NifleySnifley/RocketTracker/README.md

Currently WIP starting over all software-related development to get back on track making the most efficient design possible.
