NifleySnifley/RocketTracker/hardware/CONREVSMA003.062/CONREVSMA003.062.step

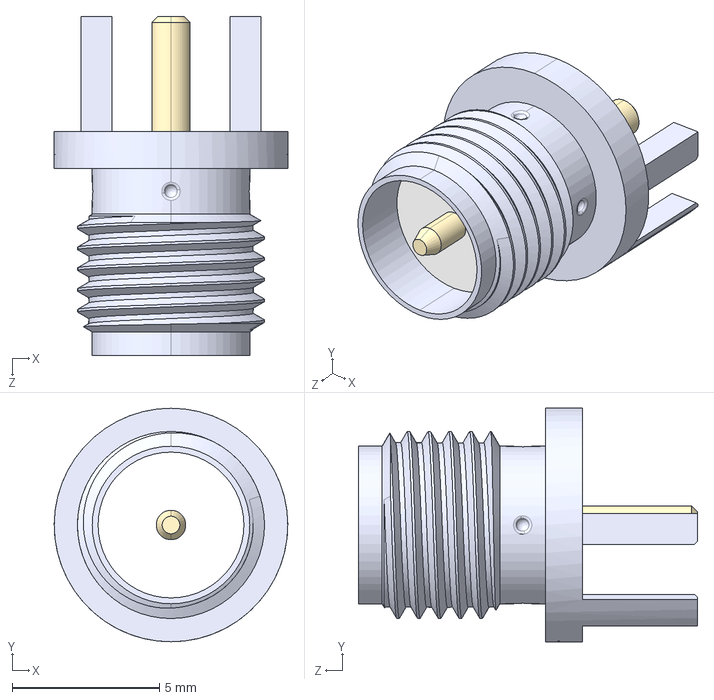
[picture p1: CAD file, 2023-04-13, last stored version]
hardware/CONREVSMA003.062/CONREVSMA003.062.step
7.93 x 7.93 x 11.5 mm
