NifleySnifley/RocketTracker/hardware/Rocket Tracker/Rocket Tracker.kicad_pcb

## KiCad design hardware/Rocket Tracker/Rocket Tracker.kicad_pcb (2023-04-13, last stored version)

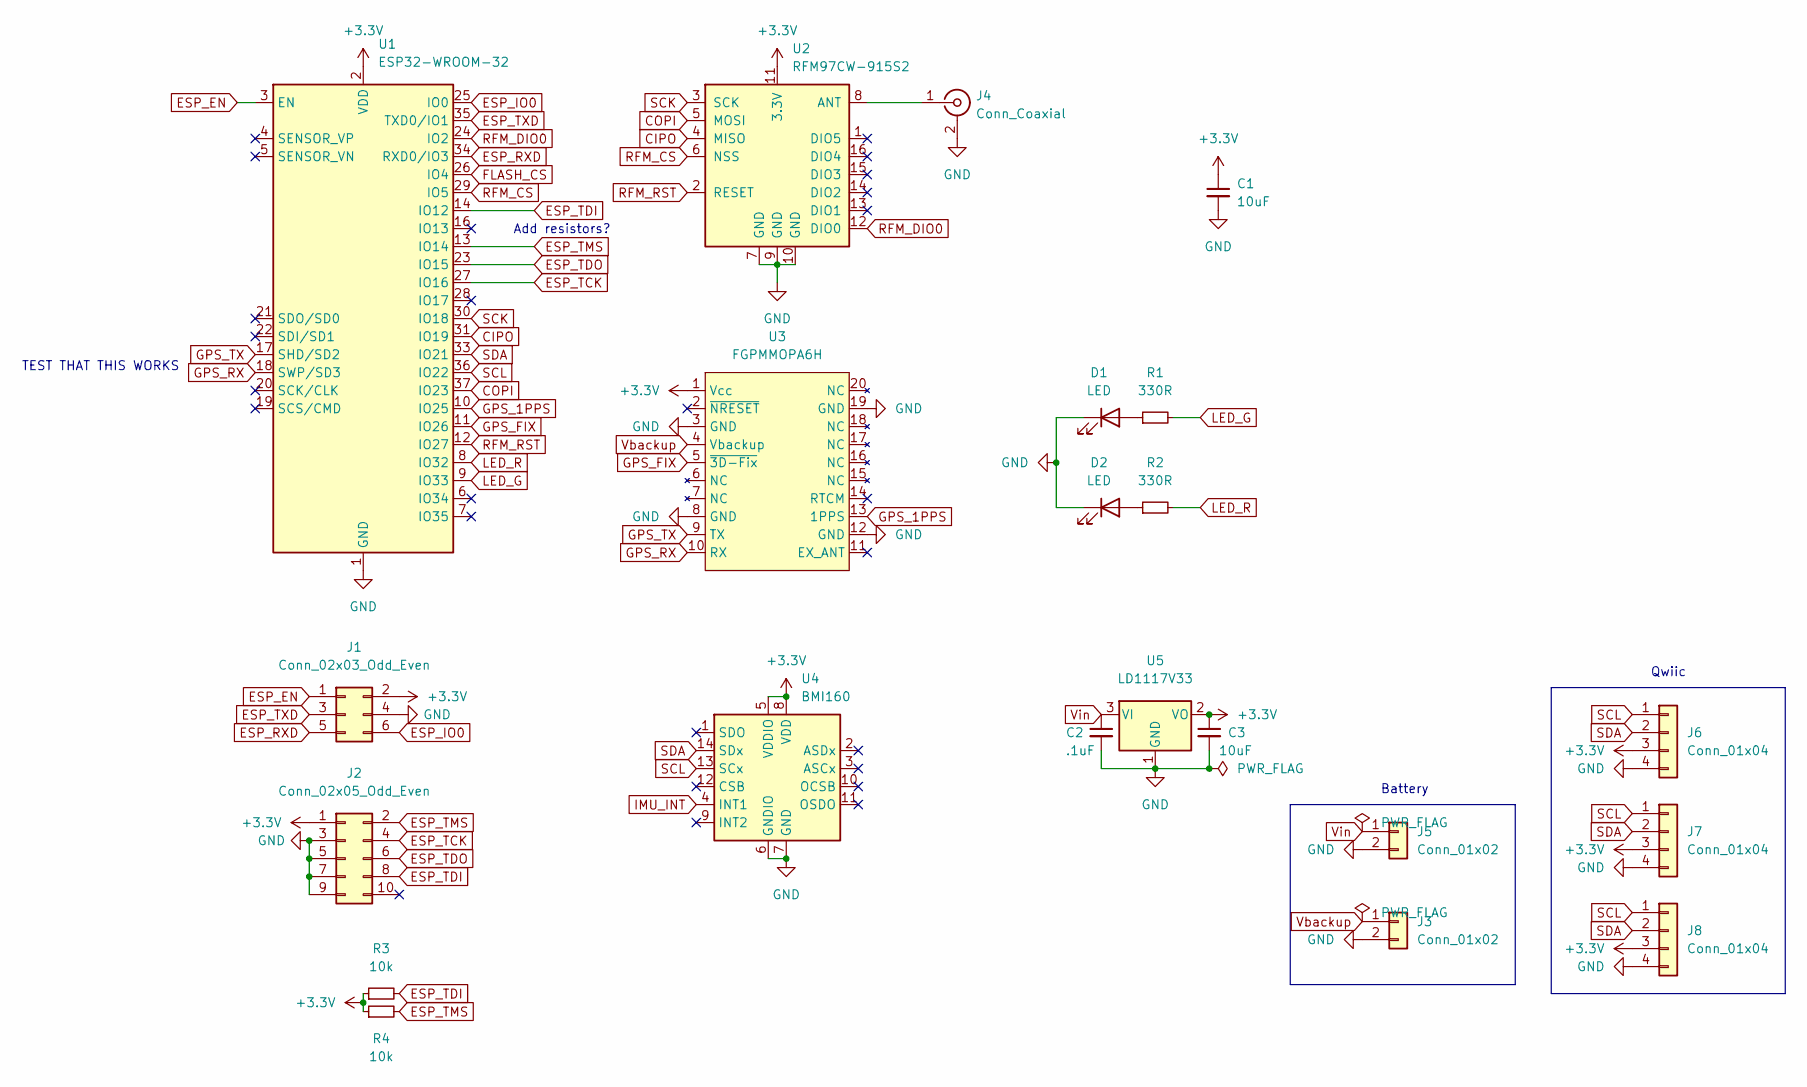
[picture p2: schematic Rocket Tracker.kicad_sch]

Parts:
C1, C3: 10uF; C_1210_3225Metric_Pad1.33x2.70mm_HandSolder
C2: .1uF; C_0603_1608Metric_Pad1.08x0.95mm_HandSolder
D1, D2: LED; LED_0603_1608Metric_Pad1.05x0.95mm_HandSolder
J1: Conn_02x03_Odd_Even; PinHeader_2x03_P1.27mm_Vertical
J2: Conn_02x05_Odd_Even; PinHeader_2x05_P1.27mm_Vertical
J3, J5: Conn_01x02; PinHeader_1x02_P2.54mm_Vertical
J4: Conn_Coaxial; LINX_CONREVSMA003.062
J6, J7, J8: Conn_01x04; Connector_Qwiic_Vertical
R1, R2: 330R; R_0603_1608Metric_Pad0.98x0.95mm_HandSolder
R3, R4: 10k; R_0603_1608Metric_Pad0.98x0.95mm_HandSolder
U1: ESP32-WROOM-32
U2: RFM97CW-915S2; HOPERF_RFM9XW_SMD
U3: FGPMMOPA6H
U4: BMI160; Bosch_LGA-14_3x2.5mm_P0.5mm
U5: LD1117V33; TO-252-2

Connections:
+3V3: C1.1, C3.1, J1.2, J2.1, J6.3, J7.3, J8.3, R3.1, R4.1, U1.2 (VDD), U2.11 (3.3V), U3.1 (Vcc), U4.5 (VDDIO), U4.8 (VDD), U5.2 (VO)
CIPO: U1.31 (IO19), U2.4 (MISO)
COPI: U1.37 (IO23), U2.5 (MOSI)
ESP_EN: J1.1, U1.3 (EN)
ESP_IO0: J1.6, U1.25 (IO0)
ESP_RXD: J1.5, U1.34 (RXD0/IO3)
ESP_TCK: J2.4, U1.27 (IO16)
ESP_TDI: J2.8, R3.2, U1.14 (IO12)
ESP_TDO: J2.6, U1.23 (IO15)
ESP_TMS: J2.2, R4.2, U1.13 (IO14)
ESP_TXD: J1.3, U1.35 (TXD0/IO1)
FLASH_CS: U1.26 (IO4)
GND: C1.2, C2.2, C3.2, D1.1 (K), D2.1 (K), J1.4, J2.3, J2.5, J2.7, J2.9, J3.2, J4.2 (Ext), J5.2, J6.4, J7.4, J8.4, U1.1 (GND), U1.15 (GND), U1.38 (GND), U1.39 (GND), U2.7 (GND), U2.9 (GND), U2.10 (GND), U3.3 (GND), U3.8 (GND), U3.12 (GND), U3.19 (GND), U4.6 (GNDIO), U4.7 (GND), U5.1 (GND)
GPS_1PPS: U1.10 (IO25), U3.13 (1PPS)
GPS_FIX: U1.11 (IO26), U3.5 (~3D-Fix)
GPS_RX: U1.18 (SWP/SD3), U3.10 (RX)
GPS_TX: U1.17 (SHD/SD2), U3.9 (TX)
IMU_INT: U4.4 (INT1)
LED_G: R1.2, U1.9 (IO33)
LED_R: R2.2, U1.8 (IO32)
unnamed: D1.2 (A), R1.1
unnamed: D2.2 (A), R2.1
unnamed: J4.1 (In), U2.8 (ANT)
RFM_CS: U1.29 (IO5), U2.6 (NSS)
RFM_DIO0: U1.24 (IO2), U2.12 (DIO0)
RFM_RST: U1.12 (IO27), U2.2 (RESET)
SCK: U1.30 (IO18), U2.3 (SCK)
SCL: J6.1, J7.1, J8.1, U1.36 (IO22), U4.13 (SCx)
SDA: J6.2, J7.2, J8.2, U1.33 (IO21), U4.14 (SDx)
Vbackup: J3.1, U3.4 (Vbackup)
Vin: C2.1, J5.1, U5.3 (VI)

Notes on the sheet:
TEST THAT THIS WORKS
Battery
Add resistors?
Qwiic

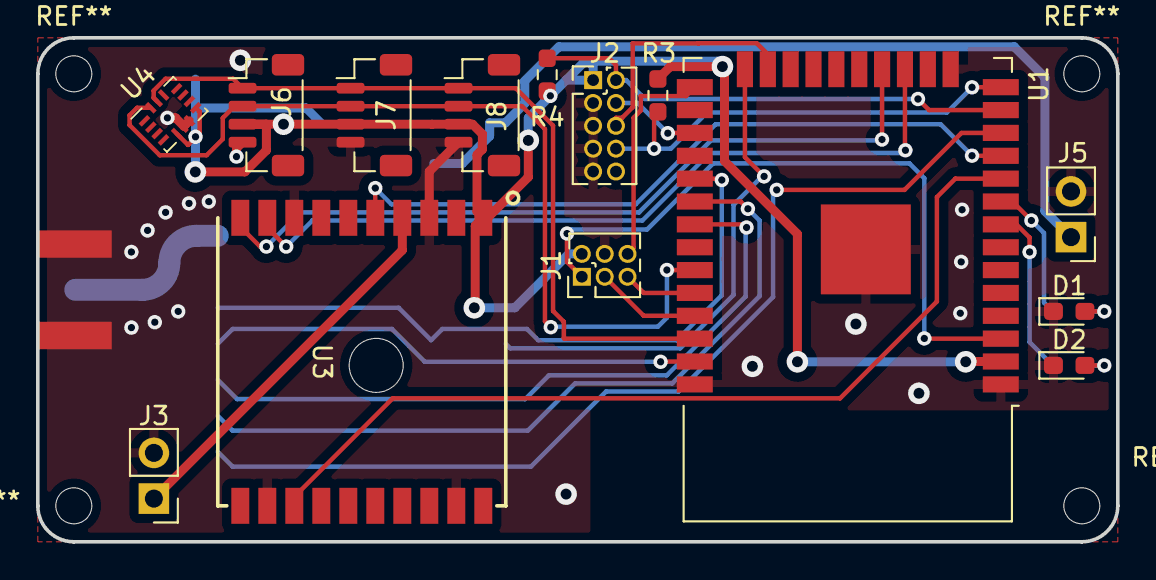
[picture p3: board Rocket Tracker.kicad_pcb from above]

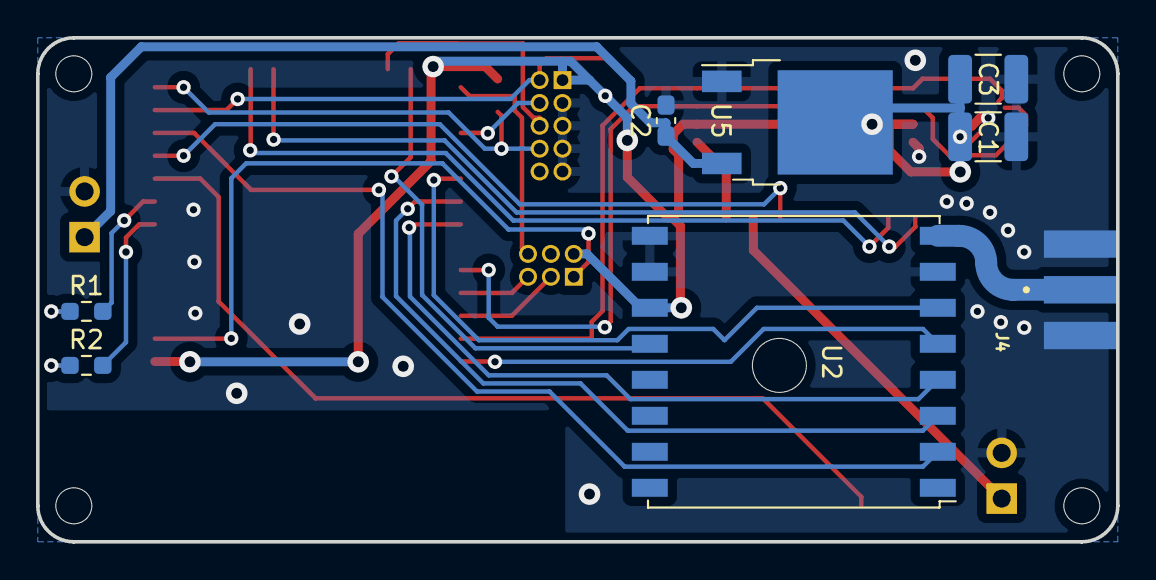
[picture p4: board Rocket Tracker.kicad_pcb from below]

Board: 2 copper layers, 60.0 x 28.0 mm, 22 parts (8 on the bottom side), 29 nets.
