NifleySnifley/RocketTracker/hardware/UniversalBaseStationHAT/UniversalBaseStationHAT.kicad_pcb

## KiCad design hardware/UniversalBaseStationHAT/UniversalBaseStationHAT.kicad_pcb (2023-04-13, last stored version)

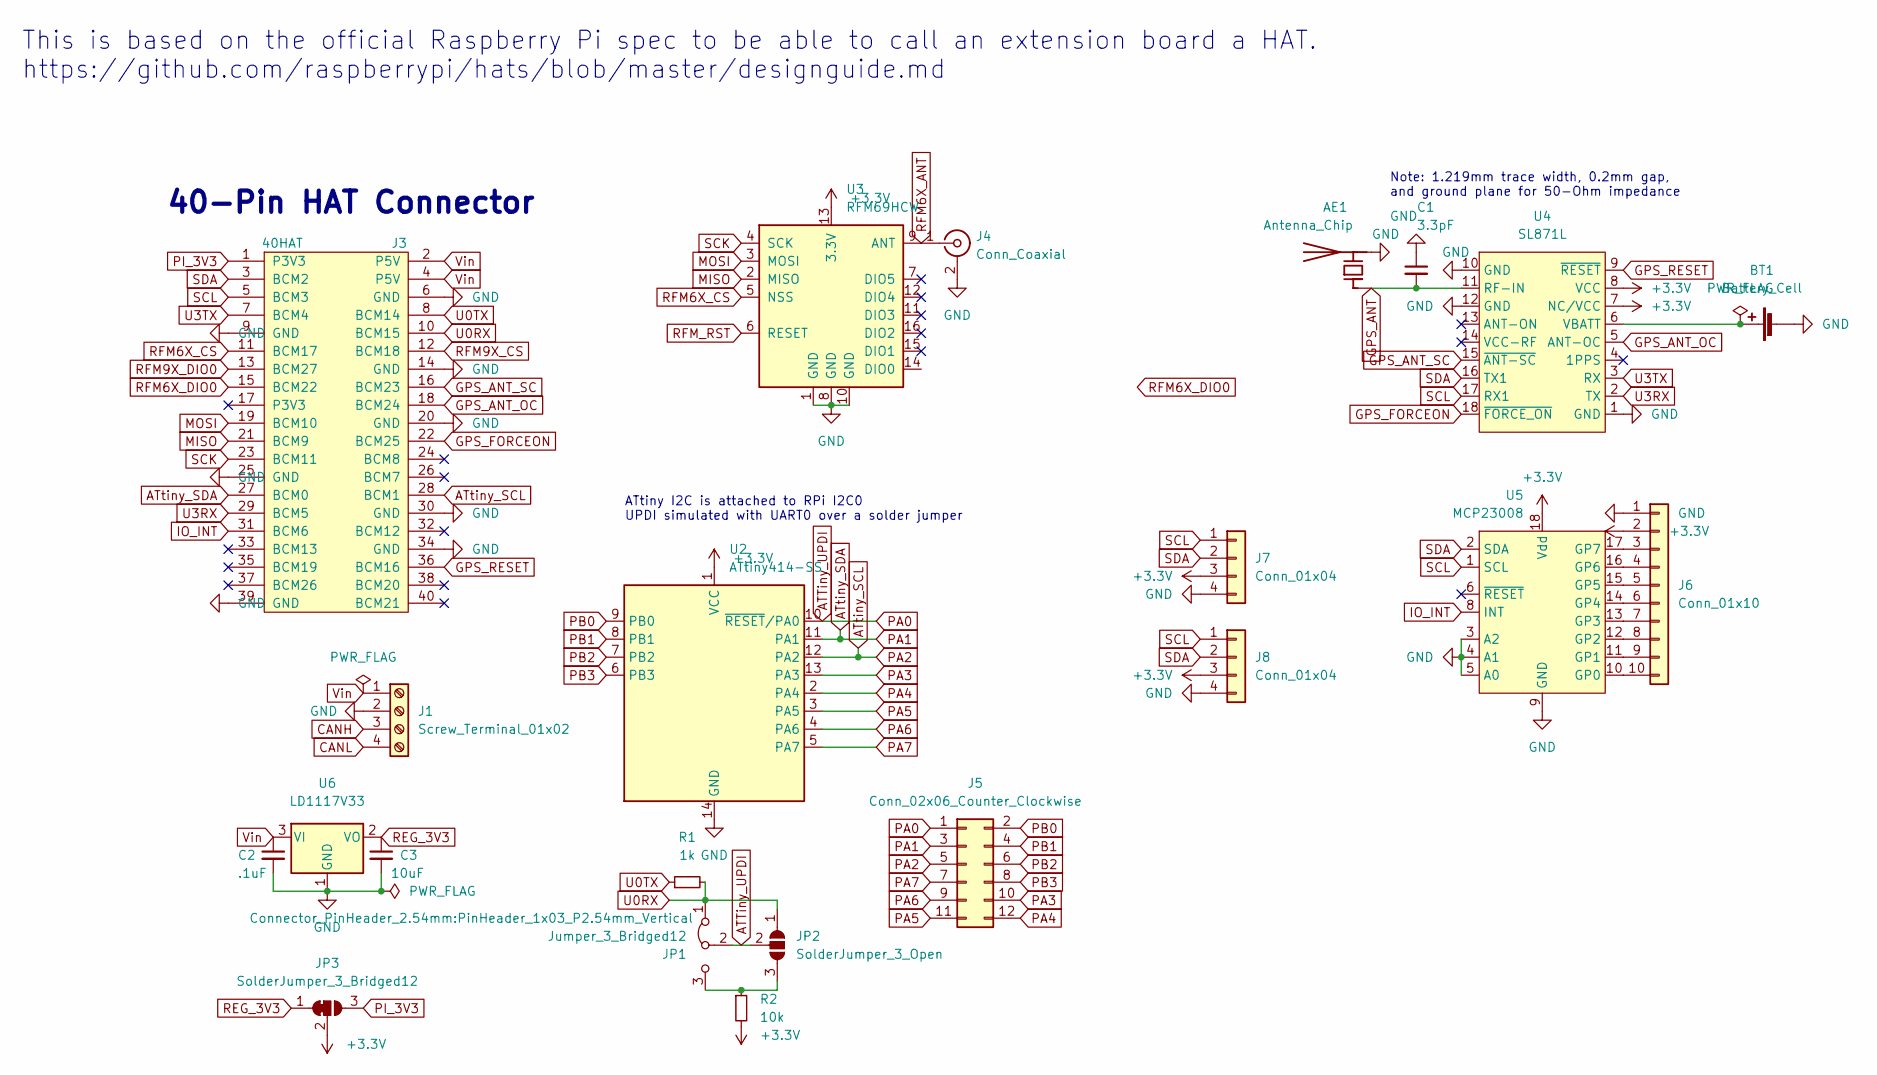
[picture p5: schematic UniversalBaseStationHAT.kicad_sch, Raspberry Pi HAT]

Parts:
AE1: Antenna_Chip; Pulse_W3011
BT1: Battery_Cell; BatteryHolder_Keystone_3000_1x12mm
C1: 3.3pF; C_0402_1005Metric_Pad0.74x0.62mm_HandSolder
C2: .1uF; C_0603_1608Metric_Pad1.08x0.95mm_HandSolder
C3: 10uF; C_1210_3225Metric_Pad1.33x2.70mm_HandSolder
J1: Screw_Terminal_01x02; TerminalBlock_bornier-4_P5.08mm
J3: 40HAT; PinSocket_2x20_P2.54mm_Vertical
J4: Conn_Coaxial; LINX_CONREVSMA003.062
J5: Conn_02x06_Counter_Clockwise; PinHeader_2x06_P2.54mm_Vertical
J6: Conn_01x10; PinHeader_1x10_P2.54mm_Vertical
J7, J8: Conn_01x04; Connector_Qwiic_Vertical
JP1: Jumper_3_Bridged12; PinHeader_1x03_P2.54mm_Vertical
JP2: SolderJumper_3_Open; SolderJumper-3_P1.3mm_Open_Pad1.0x1.5mm
JP3: SolderJumper_3_Bridged12; SolderJumper-3_P1.3mm_Bridged12_Pad1.0x1.5mm
R1: 1k; R_0603_1608Metric_Pad0.98x0.95mm_HandSolder
R2: 10k; R_0603_1608Metric_Pad0.98x0.95mm_HandSolder
U2: ATtiny414-SS; SOIC-14_3.9x8.7mm_P1.27mm
U3: RFM69HCW; HOPERF_RFM69HW
U4: SL871L; SL871
U5: MCP23008; DIP-18_W7.62mm_LongPads
U6: LD1117V33; TO-252-2

Connections:
+3V3: J6.2, J7.3, J8.3, JP3.2 (C), R2.2, U2.1 (VCC), U3.13 (3.3V), U4.7 (NC/VCC), U4.8 (VCC), U5.18 (Vdd)
ATTiny_UPDI: J5.1, JP1.2 (C), JP2.2 (C), U2.10 (~RESET/PA0)
ATtiny_SCL: J3.28 (BCM1), J5.5, U2.12 (PA2)
ATtiny_SDA: J3.27 (BCM0), J5.3, U2.11 (PA1)
CANH: J1.3
CANL: J1.4
GND: AE1.2 (PCB_Trace), BT1.2 (-), C1.1, C2.2, C3.2, J1.2, J3.6 (GND), J3.9 (GND), J3.14 (GND), J3.20 (GND), J3.25 (GND), J3.30 (GND), J3.34 (GND), J3.39 (GND), J4.2 (Ext), J6.1, J7.4, J8.4, U2.14 (GND), U3.1 (GND), U3.8 (GND), U3.10 (GND), U4.1 (GND), U4.10 (GND), U4.12 (GND), U5.3 (A2), U5.4 (A1), U5.5 (A0), U5.9 (GND), U6.1 (GND)
GPS_ANT: AE1.1 (FEED), C1.2, U4.11 (RF-IN)
GPS_ANT_OC: J3.18 (BCM24), U4.5 (ANT-OC)
GPS_ANT_SC: J3.16 (BCM23), U4.15 (~ANT-SC)
GPS_FORCEON: J3.22 (BCM25), U4.18 (~FORCE_ON)
GPS_RESET: J3.36 (BCM16), U4.9 (~RESET)
IO_INT: J3.31 (BCM6), U5.8 (INT)
MISO: J3.21 (BCM9), U3.2 (MISO)
MOSI: J3.19 (BCM10), U3.3 (MOSI)
unnamed: BT1.1 (+), U4.6 (VBATT)
unnamed: J6.3, U5.17 (GP7)
unnamed: J6.4, U5.16 (GP6)
unnamed: J6.5, U5.15 (GP5)
unnamed: J6.6, U5.14 (GP4)
unnamed: J6.7, U5.13 (GP3)
unnamed: J6.8, U5.12 (GP2)
unnamed: J6.9, U5.11 (GP1)
unnamed: J6.10, U5.10 (GP0)
unnamed: JP1.3 (B), JP2.3 (B), R2.1
PA3: J5.10, U2.13 (PA3)
PA4: J5.12, U2.2 (PA4)
PA5: J5.11, U2.3 (PA5)
PA6: J5.9, U2.4 (PA6)
PA7: J5.7, U2.5 (PA7)
PB0: J5.2, U2.9 (PB0)
PB1: J5.4, U2.8 (PB1)
PB2: J5.6, U2.7 (PB2)
PB3: J5.8, U2.6 (PB3)
PI_3V3: J3.1 (P3V3), JP3.3 (B)
REG_3V3: C3.1, JP3.1 (A), U6.2 (VO)
RFM6X_ANT: J4.1 (In), U3.9 (ANT)
RFM6X_CS: J3.11 (BCM17), U3.5 (NSS)
RFM6X_DIO0: J3.15 (BCM22)
RFM9X_CS: J3.12 (BCM18)
RFM9X_DIO0: J3.13 (BCM27)
RFM_RST: U3.6 (RESET)
SCK: J3.23 (BCM11), U3.4 (SCK)
SCL: J3.5 (BCM3), J7.1, J8.1, U4.17 (RX1), U5.1 (SCL)
SDA: J3.3 (BCM2), J7.2, J8.2, U4.16 (TX1), U5.2 (SDA)
U0RX: J3.10 (BCM15), JP1.1 (A), JP2.1 (A), R1.2
U0TX: J3.8 (BCM14), R1.1
U3RX: J3.29 (BCM5), U4.2 (TX)
U3TX: J3.7 (BCM4), U4.3 (RX)
Vin: C2.1, J1.1, J3.2 (P5V), J3.4 (P5V), U6.3 (VI)

Notes on the sheet:
This is based on the official Raspberry Pi spec to be able to call an extension board a HAT. https://github.com/raspberrypi/hats/blob/master/designguide.md
40-Pin HAT Connector
Note: 1.219mm trace width, 0.2mm gap, and ground plane for 50-Ohm impedance
ATtiny I2C is attached to RPi I2C0 UPDI simulated with UART0 over a solder jumper

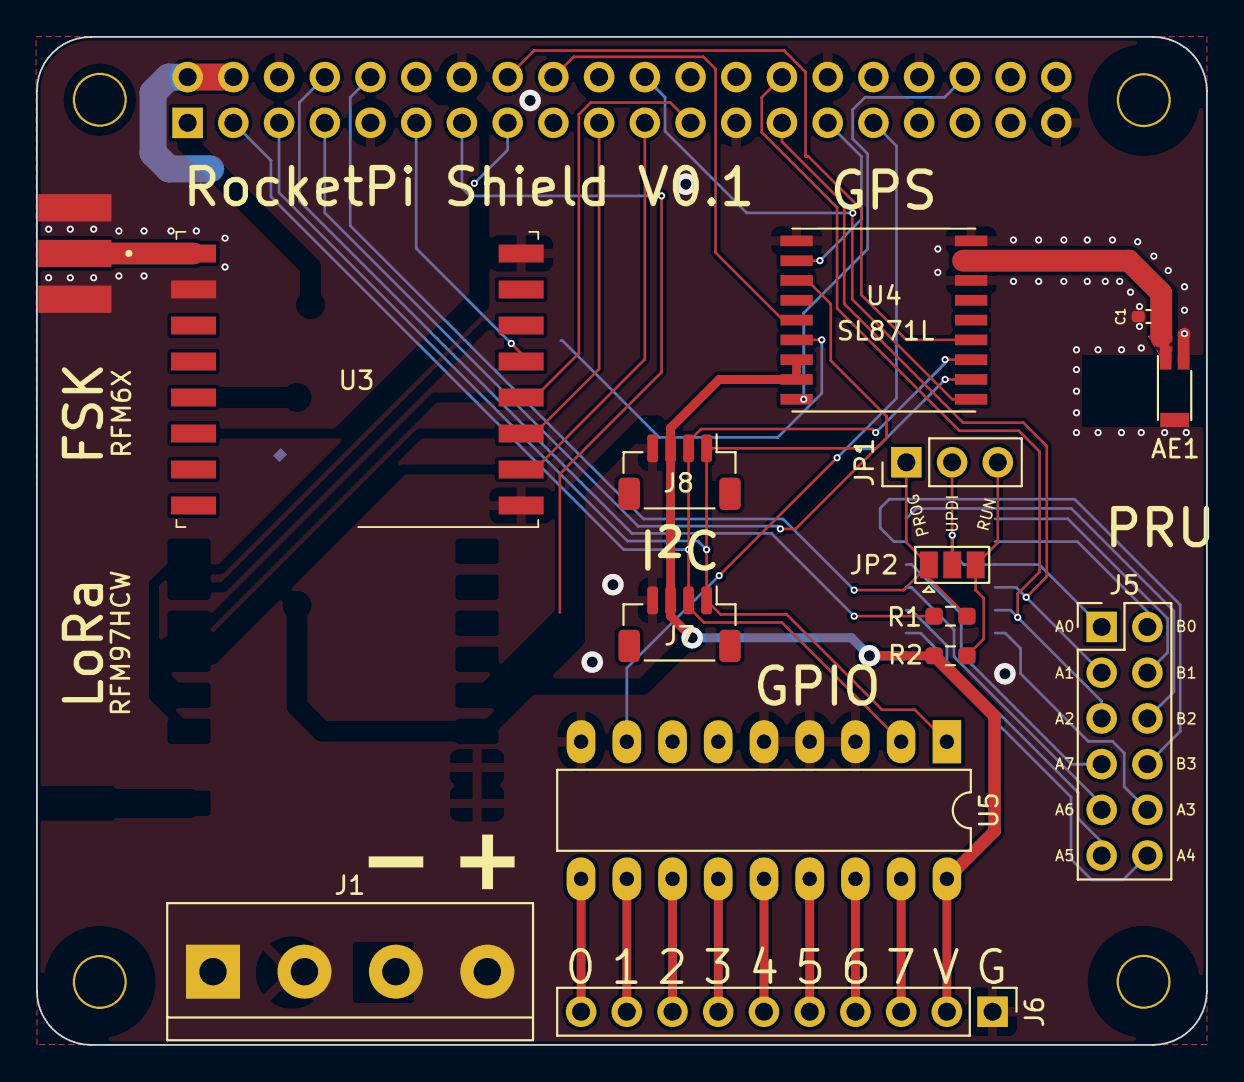
[picture p6: board UniversalBaseStationHAT.kicad_pcb from above]

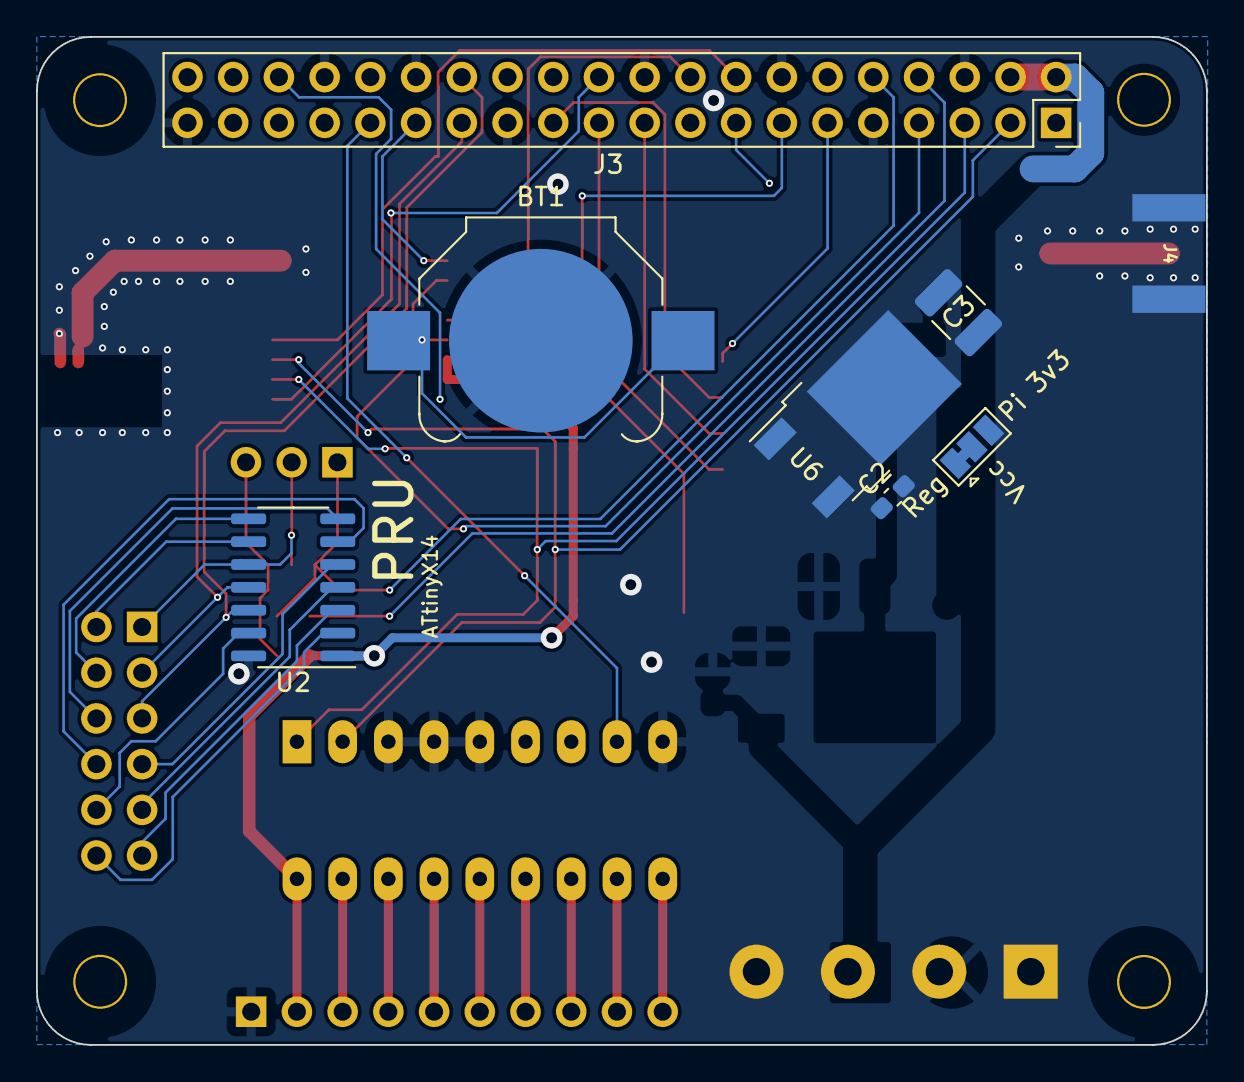
[picture p7: board UniversalBaseStationHAT.kicad_pcb from below]

Board: 2 copper layers, 65.0 x 56.0 mm, 26 parts (7 on the bottom side), 44 nets.

Other parts of the board:
H1, H2, H3, H4: 3mm_Mounting_Hole; NPTH_3mm_ID
