NifleySnifley/RocketTracker/RocketTracker-Sw/receiver_firmware/de_esc.py

def de_esc(bs: list[int]):
	os: list[int] = []
	i = 0
	while (i < len(bs)):
		if (bs[i] == 0xFF):
			i += 1
			if (bs[i] == 0x02):
				# print(hex(0x00), end=' ')
				os.append(0x00)
			elif (bs[i] == 0x01):
				# print(hex(0xFF), end=' ')
				os.append(0xFF)
			else:
				print(f"Invalid escape sequence at byte {i-1}!")
				break
		else:
			# print(hex(bs[i]), end=' ')
			os.append(bs[i])
		i += 1
  
	return os

if __name__ == "__main__":
	inp = "01 7D 00 0E FF 02 FF 02 40 0A 0D FF 02 FF 02 FF 02 FF 02 15 FF 02 FF 02 FF 02 FF 02 00"

	bs = [int(i, 16) for i in inp.split()]

	print([hex(b)for b in bs])
	print("De-esc-ed:")
	print(", ".join([hex(c) for c in de_esc(bs)]))
