NifleySnifley/RocketTracker/RocketTracker-Sw/tracker-firmware-v3/components/lsm6dsm/lsm6dsm_reg.c

/**
  ******************************************************************************
  * @file    lsm6dsm_reg.c
  * @author  Sensors Software Solution Team
  * @brief   LSM6DSM driver file
  ******************************************************************************
  * @attention
  *
  * <h2><center>&copy; Copyright (c) 2021 STMicroelectronics.
  * All rights reserved.</center></h2>
  *
  * This software component is licensed by ST under BSD 3-Clause license,
  * the "License"; You may not use this file except in compliance with the
  * License. You may obtain a copy of the License at:
  *                        opensource.org/licenses/BSD-3-Clause
  *
  ******************************************************************************
  */

#include "lsm6dsm_reg.h"

  /**
    * @defgroup    LSM6DSM
    * @brief       This file provides a set of functions needed to drive the
    *              lsm6dsm enanced inertial module.
    * @{
    *
    */

    /**
      * @defgroup    LSM6DSM_interfaces_functions
      * @brief       This section provide a set of functions used to read and
      *              write a generic register of the device.
      *              MANDATORY: return 0 -> no Error.
      * @{
      *
      */

      /**
        * @brief  Read generic device register
        *
        * @param  ctx   read / write interface definitions(ptr)
        * @param  reg   register to read
        * @param  data  pointer to buffer that store the data read(ptr)
        * @param  len   number of consecutive register to read
        * @retval       interface status (MANDATORY: return 0 -> no Error)
        *
        */
int32_t __weak lsm6dsm_read_reg(const stmdev_ctx_t* ctx, uint8_t reg,
    uint8_t* data,
    uint16_t len) {
    int32_t ret;

    if (ctx == NULL) {
        return -1;
    }

    ret = ctx->read_reg(ctx->handle, reg, data, len);

    return ret;
}

/**
  * @brief  Write generic device register
  *
  * @param  ctx   read / write interface definitions(ptr)
  * @param  reg   register to write
  * @param  data  pointer to data to write in register reg(ptr)
  * @param  len   number of consecutive register to write
  * @retval       interface status (MANDATORY: return 0 -> no Error)
  *
  */
int32_t __weak lsm6dsm_write_reg(const stmdev_ctx_t* ctx, uint8_t reg,
    uint8_t* data,
    uint16_t len) {
    int32_t ret;

    if (ctx == NULL) {
        return -1;
    }

    ret = ctx->write_reg(ctx->handle, reg, data, len);

    return ret;
}

/**
  * @}
  *
  */

  /**
    * @defgroup    LSM6DSM_Sensitivity
    * @brief       These functions convert raw-data into engineering units.
    * @{
    *
    */

float_t lsm6dsm_from_fs2g_to_mg(int16_t lsb) {
    return ((float_t)lsb * 0.061f);
}

float_t lsm6dsm_from_fs4g_to_mg(int16_t lsb) {
    return ((float_t)lsb * 0.122f);
}

float_t lsm6dsm_from_fs8g_to_mg(int16_t lsb) {
    return ((float_t)lsb * 0.244f);
}

float_t lsm6dsm_from_fs16g_to_mg(int16_t lsb) {
    return ((float_t)lsb * 0.488f);
}

float_t lsm6dsm_from_fs125dps_to_mdps(int16_t lsb) {
    return ((float_t)lsb * 4.375f);
}

float_t lsm6dsm_from_fs250dps_to_mdps(int16_t lsb) {
    return ((float_t)lsb * 8.750f);
}

float_t lsm6dsm_from_fs500dps_to_mdps(int16_t lsb) {
    return ((float_t)lsb * 17.50f);
}

float_t lsm6dsm_from_fs1000dps_to_mdps(int16_t lsb) {
    return ((float_t)lsb * 35.0f);
}

float_t lsm6dsm_from_fs2000dps_to_mdps(int16_t lsb) {
    return ((float_t)lsb * 70.0f);
}

float_t lsm6dsm_from_lsb_to_celsius(int16_t lsb) {
    return (((float_t)lsb / 256.0f) + 25.0f);
}

/**
  * @}
  *
  */


  /**
    * @defgroup    LSM6DSM_data_generation
    * @brief       This section groups all the functions concerning data
    *              generation
    * @{
    *
    */

    /**
      * @brief  Accelerometer full-scale selection.[set]
      *
      * @param  ctx    Read / write interface definitions
      * @param  val    Change the values of fs_xl in reg CTRL1_XL
      * @retval        Interface status (MANDATORY: return 0 -> no Error).
      *
      */
int32_t lsm6dsm_xl_full_scale_set(const stmdev_ctx_t* ctx,
    lsm6dsm_fs_xl_t val) {
    lsm6dsm_ctrl1_xl_t ctrl1_xl;
    int32_t ret;

    ret = lsm6dsm_read_reg(ctx, LSM6DSM_CTRL1_XL, (uint8_t*)&ctrl1_xl, 1);

    if (ret == 0) {
        ctrl1_xl.fs_xl = (uint8_t)val;
        ret = lsm6dsm_write_reg(ctx, LSM6DSM_CTRL1_XL, (uint8_t*)&ctrl1_xl, 1);
    }

    return ret;
}

/**
  * @brief  Accelerometer full-scale selection.[get]
  *
  * @param  ctx    Read / write interface definitions
  * @param  val    Get the values of fs_xl in reg CTRL1_XL
  * @retval        Interface status (MANDATORY: return 0 -> no Error).
  *
  */
int32_t lsm6dsm_xl_full_scale_get(const stmdev_ctx_t* ctx,
    lsm6dsm_fs_xl_t* val) {
    lsm6dsm_ctrl1_xl_t ctrl1_xl;
    int32_t ret;

    ret = lsm6dsm_read_reg(ctx, LSM6DSM_CTRL1_XL, (uint8_t*)&ctrl1_xl, 1);

    switch (ctrl1_xl.fs_xl) {
        case LSM6DSM_2g:
            *val = LSM6DSM_2g;
            break;

        case LSM6DSM_16g:
            *val = LSM6DSM_16g;
            break;

        case LSM6DSM_4g:
            *val = LSM6DSM_4g;
            break;

        case LSM6DSM_8g:
            *val = LSM6DSM_8g;
            break;

        default:
            *val = LSM6DSM_2g;
            break;
    }

    return ret;
}

/**
  * @brief  Accelerometer data rate selection.[set]
  *
  * @param  ctx    Read / write interface definitions
  * @param  val    Change the values of odr_xl in reg CTRL1_XL
  * @retval        Interface status (MANDATORY: return 0 -> no Error).
  *
  */
int32_t lsm6dsm_xl_data_rate_set(const stmdev_ctx_t* ctx,
    lsm6dsm_odr_xl_t val) {
    lsm6dsm_ctrl1_xl_t ctrl1_xl;
    int32_t ret;

    ret = lsm6dsm_read_reg(ctx, LSM6DSM_CTRL1_XL, (uint8_t*)&ctrl1_xl, 1);

    if (ret == 0) {
        ctrl1_xl.odr_xl = (uint8_t)val;
        ret = lsm6dsm_write_reg(ctx, LSM6DSM_CTRL1_XL, (uint8_t*)&ctrl1_xl, 1);
    }

    return ret;
}

/**
  * @brief  Accelerometer data rate selection.[get]
  *
  * @param  ctx    Read / write interface definitions
  * @param  val    Get the values of odr_xl in reg CTRL1_XL
  * @retval        Interface status (MANDATORY: return 0 -> no Error).
  *
  */
int32_t lsm6dsm_xl_data_rate_get(const stmdev_ctx_t* ctx,
    lsm6dsm_odr_xl_t* val) {
    lsm6dsm_ctrl1_xl_t ctrl1_xl;
    int32_t ret;

    ret = lsm6dsm_read_reg(ctx, LSM6DSM_CTRL1_XL, (uint8_t*)&ctrl1_xl, 1);

    switch (ctrl1_xl.odr_xl) {
        case LSM6DSM_XL_ODR_OFF:
            *val = LSM6DSM_XL_ODR_OFF;
            break;

        case LSM6DSM_XL_ODR_12Hz5:
            *val = LSM6DSM_XL_ODR_12Hz5;
            break;

        case LSM6DSM_XL_ODR_26Hz:
            *val = LSM6DSM_XL_ODR_26Hz;
            break;

        case LSM6DSM_XL_ODR_52Hz:
            *val = LSM6DSM_XL_ODR_52Hz;
            break;

        case LSM6DSM_XL_ODR_104Hz:
            *val = LSM6DSM_XL_ODR_104Hz;
            break;

        case LSM6DSM_XL_ODR_208Hz:
            *val = LSM6DSM_XL_ODR_208Hz;
            break;

        case LSM6DSM_XL_ODR_416Hz:
            *val = LSM6DSM_XL_ODR_416Hz;
            break;

        case LSM6DSM_XL_ODR_833Hz:
            *val = LSM6DSM_XL_ODR_833Hz;
            break;

        case LSM6DSM_XL_ODR_1k66Hz:
            *val = LSM6DSM_XL_ODR_1k66Hz;
            break;

        case LSM6DSM_XL_ODR_3k33Hz:
            *val = LSM6DSM_XL_ODR_3k33Hz;
            break;

        case LSM6DSM_XL_ODR_6k66Hz:
            *val = LSM6DSM_XL_ODR_6k66Hz;
            break;

        case LSM6DSM_XL_ODR_1Hz6:
            *val = LSM6DSM_XL_ODR_1Hz6;
            break;

        default:
            *val = LSM6DSM_XL_ODR_OFF;
            break;
    }

    return ret;
}

/**
  * @brief  Gyroscope chain full-scale selection.[set]
  *
  * @param  ctx    Read / write interface definitions
  * @param  val    Change the values of fs_g in reg CTRL2_G
  * @retval        Interface status (MANDATORY: return 0 -> no Error).
  *
  */
int32_t lsm6dsm_gy_full_scale_set(const stmdev_ctx_t* ctx,
    lsm6dsm_fs_g_t val) {
    lsm6dsm_ctrl2_g_t ctrl2_g;
    int32_t ret;

    ret = lsm6dsm_read_reg(ctx, LSM6DSM_CTRL2_G, (uint8_t*)&ctrl2_g, 1);

    if (ret == 0) {
        ctrl2_g.fs_g = (uint8_t)val;
        ret = lsm6dsm_write_reg(ctx, LSM6DSM_CTRL2_G, (uint8_t*)&ctrl2_g, 1);
    }

    return ret;
}

/**
  * @brief  Gyroscope chain full-scale selection.[get]
  *
  * @param  ctx    Read / write interface definitions
  * @param  val    Get the values of fs_g in reg CTRL2_G
  * @retval        Interface status (MANDATORY: return 0 -> no Error).
  *
  */
int32_t lsm6dsm_gy_full_scale_get(const stmdev_ctx_t* ctx,
    lsm6dsm_fs_g_t* val) {
    lsm6dsm_ctrl2_g_t ctrl2_g;
    int32_t ret;

    ret = lsm6dsm_read_reg(ctx, LSM6DSM_CTRL2_G, (uint8_t*)&ctrl2_g, 1);

    switch (ctrl2_g.fs_g) {
        case LSM6DSM_250dps:
            *val = LSM6DSM_250dps;
            break;

        case LSM6DSM_125dps:
            *val = LSM6DSM_125dps;
            break;

        case LSM6DSM_500dps:
            *val = LSM6DSM_500dps;
            break;

        case LSM6DSM_1000dps:
            *val = LSM6DSM_1000dps;
            break;

        case LSM6DSM_2000dps:
            *val = LSM6DSM_2000dps;
            break;

        default:
            *val = LSM6DSM_250dps;
            break;
    }

    return ret;
}

/**
  * @brief  Gyroscope data rate selection.[set]
  *
  * @param  ctx    Read / write interface definitions
  * @param  val    Change the values of odr_g in reg CTRL2_G
  * @retval        Interface status (MANDATORY: return 0 -> no Error).
  *
  */
int32_t lsm6dsm_gy_data_rate_set(const stmdev_ctx_t* ctx,
    lsm6dsm_odr_g_t val) {
    lsm6dsm_ctrl2_g_t ctrl2_g;
    int32_t ret;

    ret = lsm6dsm_read_reg(ctx, LSM6DSM_CTRL2_G, (uint8_t*)&ctrl2_g, 1);

    if (ret == 0) {
        ctrl2_g.odr_g = (uint8_t)val;
        ret = lsm6dsm_write_reg(ctx, LSM6DSM_CTRL2_G, (uint8_t*)&ctrl2_g, 1);
    }

    return ret;
}

/**
  * @brief  Gyroscope data rate selection.[get]
  *
  * @param  ctx    Read / write interface definitions
  * @param  val    Get the values of odr_g in reg CTRL2_G
  * @retval        Interface status (MANDATORY: return 0 -> no Error).
  *
  */
int32_t lsm6dsm_gy_data_rate_get(const stmdev_ctx_t* ctx,
    lsm6dsm_odr_g_t* val) {
    lsm6dsm_ctrl2_g_t ctrl2_g;
    int32_t ret;

    ret = lsm6dsm_read_reg(ctx, LSM6DSM_CTRL2_G, (uint8_t*)&ctrl2_g, 1);

    switch (ctrl2_g.odr_g) {
        case LSM6DSM_GY_ODR_OFF:
            *val = LSM6DSM_GY_ODR_OFF;
            break;

        case LSM6DSM_GY_ODR_12Hz5:
            *val = LSM6DSM_GY_ODR_12Hz5;
            break;

        case LSM6DSM_GY_ODR_26Hz:
            *val = LSM6DSM_GY_ODR_26Hz;
            break;

        case LSM6DSM_GY_ODR_52Hz:
            *val = LSM6DSM_GY_ODR_52Hz;
            break;

        case LSM6DSM_GY_ODR_104Hz:
            *val = LSM6DSM_GY_ODR_104Hz;
            break;

        case LSM6DSM_GY_ODR_208Hz:
            *val = LSM6DSM_GY_ODR_208Hz;
            break;

        case LSM6DSM_GY_ODR_416Hz:
            *val = LSM6DSM_GY_ODR_416Hz;
            break;

        case LSM6DSM_GY_ODR_833Hz:
            *val = LSM6DSM_GY_ODR_833Hz;
            break;

        case LSM6DSM_GY_ODR_1k66Hz:
            *val = LSM6DSM_GY_ODR_1k66Hz;
            break;

        case LSM6DSM_GY_ODR_3k33Hz:
            *val = LSM6DSM_GY_ODR_3k33Hz;
            break;

        case LSM6DSM_GY_ODR_6k66Hz:
            *val = LSM6DSM_GY_ODR_6k66Hz;
            break;

        default:
            *val = LSM6DSM_GY_ODR_OFF;
            break;
    }

    return ret;
}

/**
  * @brief  Block data update.[set]
  *
  * @param  ctx    Read / write interface definitions
  * @param  val    Change the values of bdu in reg CTRL3_C
  * @retval        Interface status (MANDATORY: return 0 -> no Error).
  *
  */
int32_t lsm6dsm_block_data_update_set(const stmdev_ctx_t* ctx, uint8_t val) {
    lsm6dsm_ctrl3_c_t ctrl3_c;
    int32_t ret;

    ret = lsm6dsm_read_reg(ctx, LSM6DSM_CTRL3_C, (uint8_t*)&ctrl3_c, 1);

    if (ret == 0) {
        ctrl3_c.bdu = val;
        ret = lsm6dsm_write_reg(ctx, LSM6DSM_CTRL3_C, (uint8_t*)&ctrl3_c, 1);
    }

    return ret;
}

/**
  * @brief  Block data update.[get]
  *
  * @param  ctx    Read / write interface definitions
  * @param  val    Change the values of bdu in reg CTRL3_C
  * @retval        Interface status (MANDATORY: return 0 -> no Error).
  *
  */
int32_t lsm6dsm_block_data_update_get(const stmdev_ctx_t* ctx, uint8_t* val) {
    lsm6dsm_ctrl3_c_t ctrl3_c;
    int32_t ret;

    ret = lsm6dsm_read_reg(ctx, LSM6DSM_CTRL3_C, (uint8_t*)&ctrl3_c, 1);
    *val = ctrl3_c.bdu;

    return ret;
}

/**
  * @brief  Weight of XL user offset bits of registers
  *         X_OFS_USR(73h), Y_OFS_USR(74h), Z_OFS_USR(75h).[set]
  *
  * @param  ctx    Read / write interface definitions
  * @param  val    Change the values of usr_off_w in reg CTRL6_C
  * @retval        Interface status (MANDATORY: return 0 -> no Error).
  *
  */
int32_t lsm6dsm_xl_offset_weight_set(const stmdev_ctx_t* ctx,
    lsm6dsm_usr_off_w_t val) {
    lsm6dsm_ctrl6_c_t ctrl6_c;
    int32_t ret;

    ret = lsm6dsm_read_reg(ctx, LSM6DSM_CTRL6_C, (uint8_t*)&ctrl6_c, 1);

    if (ret == 0) {
        ctrl6_c.usr_off_w = (uint8_t)val;
        ret = lsm6dsm_write_reg(ctx, LSM6DSM_CTRL6_C, (uint8_t*)&ctrl6_c, 1);
    }

    return ret;
}

/**
  * @brief  Weight of XL user offset bits of registers
  *         X_OFS_USR(73h), Y_OFS_USR(74h), Z_OFS_USR(75h).[get]
  *
  * @param  ctx    Read / write interface definitions
  * @param  val    Get the values of usr_off_w in reg CTRL6_C
  * @retval        Interface status (MANDATORY: return 0 -> no Error).
  *
  */
int32_t lsm6dsm_xl_offset_weight_get(const stmdev_ctx_t* ctx,
    lsm6dsm_usr_off_w_t* val) {
    lsm6dsm_ctrl6_c_t ctrl6_c;
    int32_t ret;

    ret = lsm6dsm_read_reg(ctx, LSM6DSM_CTRL6_C, (uint8_t*)&ctrl6_c, 1);

    switch (ctrl6_c.usr_off_w) {
        case LSM6DSM_LSb_1mg:
            *val = LSM6DSM_LSb_1mg;
            break;

        case LSM6DSM_LSb_16mg:
            *val = LSM6DSM_LSb_16mg;
            break;

        default:
            *val = LSM6DSM_LSb_1mg;
            break;
    }

    return ret;
}

/**
  * @brief  High-performance operating mode for accelerometer[set]
  *
  * @param  ctx    Read / write interface definitions
  * @param  val    Change the values of xl_hm_mode in reg CTRL6_C
  * @retval        Interface status (MANDATORY: return 0 -> no Error).
  *
  */
int32_t lsm6dsm_xl_power_mode_set(const stmdev_ctx_t* ctx,
    lsm6dsm_xl_hm_mode_t val) {
    lsm6dsm_ctrl6_c_t ctrl6_c;
    int32_t ret;

    ret = lsm6dsm_read_reg(ctx, LSM6DSM_CTRL6_C, (uint8_t*)&ctrl6_c, 1);

    if (ret == 0) {
        ctrl6_c.xl_hm_mode = (uint8_t)val;
        ret = lsm6dsm_write_reg(ctx, LSM6DSM_CTRL6_C, (uint8_t*)&ctrl6_c, 1);
    }

    return ret;
}

/**
  * @brief  High-performance operating mode for accelerometer.[get]
  *
  * @param  ctx    Read / write interface definitions
  * @param  val    Get the values of xl_hm_mode in reg CTRL6_C
  * @retval        Interface status (MANDATORY: return 0 -> no Error).
  *
  */
int32_t lsm6dsm_xl_power_mode_get(const stmdev_ctx_t* ctx,
    lsm6dsm_xl_hm_mode_t* val) {
    lsm6dsm_ctrl6_c_t ctrl6_c;
    int32_t ret;

    ret = lsm6dsm_read_reg(ctx, LSM6DSM_CTRL6_C, (uint8_t*)&ctrl6_c, 1);

    switch (ctrl6_c.xl_hm_mode) {
        case LSM6DSM_XL_HIGH_PERFORMANCE:
            *val = LSM6DSM_XL_HIGH_PERFORMANCE;
            break;

        case LSM6DSM_XL_NORMAL:
            *val = LSM6DSM_XL_NORMAL;
            break;

        default:
            *val = LSM6DSM_XL_HIGH_PERFORMANCE;
            break;
    }

    return ret;
}

/**
  * @brief  Source register rounding function on WAKE_UP_SRC (1Bh),
  *         TAP_SRC (1Ch), D6D_SRC (1Dh), STATUS_REG (1Eh) and
  *         FUNC_SRC1 (53h) registers in the primary interface.[set]
  *
  * @param  ctx    Read / write interface definitions
  * @param  val    Change the values of rounding_status in reg CTRL7_G
  * @retval        Interface status (MANDATORY: return 0 -> no Error).
  *
  */
int32_t lsm6dsm_rounding_on_status_set(const stmdev_ctx_t* ctx,
    lsm6dsm_rounding_status_t val) {
    lsm6dsm_ctrl7_g_t ctrl7_g;
    int32_t ret;

    ret = lsm6dsm_read_reg(ctx, LSM6DSM_CTRL7_G, (uint8_t*)&ctrl7_g, 1);

    if (ret == 0) {
        ctrl7_g.rounding_status = (uint8_t)val;
        ret = lsm6dsm_write_reg(ctx, LSM6DSM_CTRL7_G, (uint8_t*)&ctrl7_g, 1);
    }

    return ret;
}

/**
  * @brief  Source register rounding function on WAKE_UP_SRC (1Bh),
  *         TAP_SRC (1Ch), D6D_SRC (1Dh), STATUS_REG (1Eh) and
  *         FUNC_SRC1 (53h) registers in the primary interface.[get]
  *
  * @param  ctx    Read / write interface definitions
  * @param  val    Get the values of rounding_status in reg CTRL7_G
  * @retval        Interface status (MANDATORY: return 0 -> no Error).
  *
  */
int32_t lsm6dsm_rounding_on_status_get(const stmdev_ctx_t* ctx,
    lsm6dsm_rounding_status_t* val) {
    lsm6dsm_ctrl7_g_t ctrl7_g;
    int32_t ret;

    ret = lsm6dsm_read_reg(ctx, LSM6DSM_CTRL7_G, (uint8_t*)&ctrl7_g, 1);

    switch (ctrl7_g.rounding_status) {
        case LSM6DSM_STAT_RND_DISABLE:
            *val = LSM6DSM_STAT_RND_DISABLE;
            break;

        case LSM6DSM_STAT_RND_ENABLE:
            *val = LSM6DSM_STAT_RND_ENABLE;
            break;

        default:
            *val = LSM6DSM_STAT_RND_DISABLE;
            break;
    }

    return ret;
}

/**
  * @brief  High-performance operating mode disable for gyroscope.[set]
  *
  * @param  ctx    Read / write interface definitions
  * @param  val    Change the values of g_hm_mode in reg CTRL7_G
  * @retval        Interface status (MANDATORY: return 0 -> no Error).
  *
  */
int32_t lsm6dsm_gy_power_mode_set(const stmdev_ctx_t* ctx,
    lsm6dsm_g_hm_mode_t val) {
    lsm6dsm_ctrl7_g_t ctrl7_g;
    int32_t ret;

    ret = lsm6dsm_read_reg(ctx, LSM6DSM_CTRL7_G, (uint8_t*)&ctrl7_g, 1);

    if (ret == 0) {
        ctrl7_g.g_hm_mode = (uint8_t)val;
        ret = lsm6dsm_write_reg(ctx, LSM6DSM_CTRL7_G, (uint8_t*)&ctrl7_g, 1);
    }

    return ret;
}

/**
  * @brief  High-performance operating mode disable for gyroscope.[get]
  *
  * @param  ctx    Read / write interface definitions
  * @param  val    Get the values of g_hm_mode in reg CTRL7_G
  * @retval        Interface status (MANDATORY: return 0 -> no Error).
  *
  */
int32_t lsm6dsm_gy_power_mode_get(const stmdev_ctx_t* ctx,
    lsm6dsm_g_hm_mode_t* val) {
    lsm6dsm_ctrl7_g_t ctrl7_g;
    int32_t ret;

    ret = lsm6dsm_read_reg(ctx, LSM6DSM_CTRL7_G, (uint8_t*)&ctrl7_g, 1);

    switch (ctrl7_g.g_hm_mode) {
        case LSM6DSM_GY_HIGH_PERFORMANCE:
            *val = LSM6DSM_GY_HIGH_PERFORMANCE;
            break;

        case LSM6DSM_GY_NORMAL:
            *val = LSM6DSM_GY_NORMAL;
            break;

        default:
            *val = LSM6DSM_GY_HIGH_PERFORMANCE;
            break;
    }

    return ret;
}

/**
  * @brief  Read all the interrupt/status flag of the device.[get]
  *
  * @param  ctx    Read / write interface definitions
  * @param  val    WAKE_UP_SRC, TAP_SRC, D6D_SRC, STATUS_REG,
  *                FUNC_SRC1, FUNC_SRC2, WRIST_TILT_IA, A_WRIST_TILT_Mask
  * @retval        Interface status (MANDATORY: return 0 -> no Error).
  *
  */
int32_t lsm6dsm_all_sources_get(const stmdev_ctx_t* ctx,
    lsm6dsm_all_sources_t* val) {
    int32_t ret;

    ret = lsm6dsm_read_reg(ctx, LSM6DSM_WAKE_UP_SRC,
        (uint8_t*)&(val->wake_up_src), 1);

    if (ret == 0) {
        ret = lsm6dsm_read_reg(ctx, LSM6DSM_TAP_SRC,
            (uint8_t*)&(val->tap_src), 1);
    }

    if (ret == 0) {
        ret = lsm6dsm_read_reg(ctx, LSM6DSM_D6D_SRC,
            (uint8_t*)&(val->d6d_src), 1);
    }

    if (ret == 0) {
        ret = lsm6dsm_read_reg(ctx, LSM6DSM_STATUS_REG,
            (uint8_t*)&(val->status_reg), 1);
    }

    if (ret == 0) {
        ret = lsm6dsm_read_reg(ctx, LSM6DSM_FUNC_SRC1,
            (uint8_t*)&(val->func_src1), 1);
    }

    if (ret == 0) {
        ret = lsm6dsm_read_reg(ctx, LSM6DSM_FUNC_SRC2,
            (uint8_t*)&(val->func_src2), 1);
    }

    if (ret == 0) {
        ret = lsm6dsm_read_reg(ctx, LSM6DSM_WRIST_TILT_IA,
            (uint8_t*)&(val->wrist_tilt_ia), 1);
    }

    if (ret == 0) {
        ret = lsm6dsm_mem_bank_set(ctx, LSM6DSM_BANK_B);
    }

    if (ret == 0) {
        ret = lsm6dsm_read_reg(ctx, LSM6DSM_A_WRIST_TILT_MASK,
            (uint8_t*)&(val->a_wrist_tilt_mask), 1);
    }

    if (ret == 0) {
        ret = lsm6dsm_mem_bank_set(ctx, LSM6DSM_USER_BANK);
    }

    return ret;
}
/**
  * @brief  The STATUS_REG register is read by the primary interface[get]
  *
  * @param  ctx    Read / write interface definitions
  * @param  val    Registers STATUS_REG
  * @retval        Interface status (MANDATORY: return 0 -> no Error).
  *
  */
int32_t lsm6dsm_status_reg_get(const stmdev_ctx_t* ctx,
    lsm6dsm_status_reg_t* val) {
    int32_t ret;

    ret = lsm6dsm_read_reg(ctx, LSM6DSM_STATUS_REG, (uint8_t*)val, 1);

    return ret;
}

/**
  * @brief  Accelerometer new data available.[get]
  *
  * @param  ctx    Read / write interface definitions
  * @param  val    Change the values of xlda in reg STATUS_REG
  * @retval        Interface status (MANDATORY: return 0 -> no Error).
  *
  */
int32_t lsm6dsm_xl_flag_data_ready_get(const stmdev_ctx_t* ctx,
    uint8_t* val) {
    lsm6dsm_status_reg_t status_reg;
    int32_t ret;

    ret = lsm6dsm_read_reg(ctx, LSM6DSM_STATUS_REG,
        (uint8_t*)&status_reg, 1);
    *val = status_reg.xlda;

    return ret;
}

/**
  * @brief  Gyroscope new data available.[get]
  *
  * @param  ctx    Read / write interface definitions
  * @param  val    Change the values of gda in reg STATUS_REG
  * @retval        Interface status (MANDATORY: return 0 -> no Error).
  *
  */
int32_t lsm6dsm_gy_flag_data_ready_get(const stmdev_ctx_t* ctx,
    uint8_t* val) {
    lsm6dsm_status_reg_t status_reg;
    int32_t ret;

    ret = lsm6dsm_read_reg(ctx, LSM6DSM_STATUS_REG,
        (uint8_t*)&status_reg, 1);
    *val = status_reg.gda;

    return ret;
}

/**
  * @brief  Temperature new data available.[get]
  *
  * @param  ctx    Read / write interface definitions
  * @param  val    Change the values of tda in reg STATUS_REG
  * @retval        Interface status (MANDATORY: return 0 -> no Error).
  *
  */
int32_t lsm6dsm_temp_flag_data_ready_get(const stmdev_ctx_t* ctx,
    uint8_t* val) {
    lsm6dsm_status_reg_t status_reg;
    int32_t ret;

    ret = lsm6dsm_read_reg(ctx, LSM6DSM_STATUS_REG,
        (uint8_t*)&status_reg, 1);
    *val = status_reg.tda;

    return ret;
}

/**
  * @brief  Accelerometer axis user offset correction expressed in two’s
  *         complement, weight depends on USR_OFF_W in CTRL6_C.
  *         The value must be in the range [-127 127].[set]
  *
  * @param  ctx    Read / write interface definitions
  * @param  buff   Buffer that contains data to write
  * @retval        Interface status (MANDATORY: return 0 -> no Error).
  *
  */
int32_t lsm6dsm_xl_usr_offset_set(const stmdev_ctx_t* ctx, uint8_t* buff) {
    int32_t ret;

    ret = lsm6dsm_write_reg(ctx, LSM6DSM_X_OFS_USR, buff, 3);

    return ret;
}

/**
  * @brief  Accelerometer axis user offset correction xpressed in two’s
  *         complement, weight depends on USR_OFF_W in CTRL6_C.
  *         The value must be in the range [-127 127].[get]
  *
  * @param  ctx    Read / write interface definitions
  * @param  buff   Buffer that stores data read
  * @retval        Interface status (MANDATORY: return 0 -> no Error).
  *
  */
int32_t lsm6dsm_xl_usr_offset_get(const stmdev_ctx_t* ctx, uint8_t* buff) {
    int32_t ret;

    ret = lsm6dsm_read_reg(ctx, LSM6DSM_X_OFS_USR, buff, 3);

    return ret;
}

/**
  * @}
  *
  */

  /**
    * @defgroup    LSM6DSM_Timestamp
    * @brief       This section groups all the functions that manage the
    *              timestamp generation.
    * @{
    *
    */

    /**
      * @brief  Enable timestamp count. The count is saved in TIMESTAMP0_REG (40h),
      *         TIMESTAMP1_REG (41h) and TIMESTAMP2_REG (42h).[set]
      *
      * @param  ctx    Read / write interface definitions
      * @param  val    Change the values of timer_en in reg CTRL10_C
      * @retval        Interface status (MANDATORY: return 0 -> no Error).
      *
      */
int32_t lsm6dsm_timestamp_set(const stmdev_ctx_t* ctx, uint8_t val) {
    lsm6dsm_ctrl10_c_t ctrl10_c;
    int32_t ret;

    ret = lsm6dsm_read_reg(ctx, LSM6DSM_CTRL10_C, (uint8_t*)&ctrl10_c, 1);

    if (ret == 0) {
        ctrl10_c.timer_en = val;

        if (val != 0x00U) {
            ctrl10_c.func_en = val;
            ret = lsm6dsm_write_reg(ctx, LSM6DSM_CTRL10_C, (uint8_t*)&ctrl10_c, 1);
        }
    }

    return ret;
}

/**
  * @brief  Enable timestamp count. The count is saved in TIMESTAMP0_REG (40h),
  *         TIMESTAMP1_REG (41h) and TIMESTAMP2_REG (42h).[get]
  *
  * @param  ctx    Read / write interface definitions
  * @param  val    Change the values of timer_en in reg CTRL10_C
  * @retval        Interface status (MANDATORY: return 0 -> no Error).
  *
  */
int32_t lsm6dsm_timestamp_get(const stmdev_ctx_t* ctx, uint8_t* val) {
    lsm6dsm_ctrl10_c_t ctrl10_c;
    int32_t ret;

    ret = lsm6dsm_read_reg(ctx, LSM6DSM_CTRL10_C, (uint8_t*)&ctrl10_c, 1);
    *val = ctrl10_c.timer_en;

    return ret;
}

/**
  * @brief  Timestamp register resolution setting.
  *         Configuration of this bit affects
  *         TIMESTAMP0_REG(40h), TIMESTAMP1_REG(41h),
  *         TIMESTAMP2_REG(42h), STEP_TIMESTAMP_L(49h),
  *         STEP_TIMESTAMP_H(4Ah) and
  *         STEP_COUNT_DELTA(15h) registers.[set]
  *
  * @param  ctx    Read / write interface definitions
  * @param  val    Change the values of timer_hr in reg WAKE_UP_DUR
  * @retval        Interface status (MANDATORY: return 0 -> no Error).
  *
  */
int32_t lsm6dsm_timestamp_res_set(const stmdev_ctx_t* ctx,
    lsm6dsm_timer_hr_t val) {
    lsm6dsm_wake_up_dur_t wake_up_dur;
    int32_t ret;

    ret = lsm6dsm_read_reg(ctx, LSM6DSM_WAKE_UP_DUR,
        (uint8_t*)&wake_up_dur, 1);

    if (ret == 0) {
        wake_up_dur.timer_hr = (uint8_t)val;
        ret = lsm6dsm_write_reg(ctx, LSM6DSM_WAKE_UP_DUR,
            (uint8_t*)&wake_up_dur, 1);
    }

    return ret;
}

/**
  * @brief  Timestamp register resolution setting.
  *         Configuration of this bit affects
  *         TIMESTAMP0_REG(40h), TIMESTAMP1_REG(41h),
  *         TIMESTAMP2_REG(42h), STEP_TIMESTAMP_L(49h),
  *         STEP_TIMESTAMP_H(4Ah) and
  *         STEP_COUNT_DELTA(15h) registers.[get]
  *
  * @param  ctx    Read / write interface definitions
  * @param  val    Get the values of timer_hr in reg WAKE_UP_DUR
  * @retval        Interface status (MANDATORY: return 0 -> no Error).
  *
  */
int32_t lsm6dsm_timestamp_res_get(const stmdev_ctx_t* ctx,
    lsm6dsm_timer_hr_t* val) {
    lsm6dsm_wake_up_dur_t wake_up_dur;
    int32_t ret;

    ret = lsm6dsm_read_reg(ctx, LSM6DSM_WAKE_UP_DUR,
        (uint8_t*)&wake_up_dur, 1);

    switch (wake_up_dur.timer_hr) {
        case LSM6DSM_LSB_6ms4:
            *val = LSM6DSM_LSB_6ms4;
            break;

        case LSM6DSM_LSB_25us:
            *val = LSM6DSM_LSB_25us;
            break;

        default:
            *val = LSM6DSM_LSB_6ms4;
            break;
    }

    return ret;
}

/**
  * @}
  *
  */

  /**
    * @defgroup    LSM6DSM_Dataoutput
    * @brief       This section groups all the data output functions.
    * @{
    *
    */

    /**
      * @brief  Circular burst-mode (rounding) read from output registers
      *         through the primary interface.[set]
      *
      * @param  ctx    Read / write interface definitions
      * @param  val    Change the values of rounding in reg CTRL5_C
      * @retval        Interface status (MANDATORY: return 0 -> no Error).
      *
      */
int32_t lsm6dsm_rounding_mode_set(const stmdev_ctx_t* ctx,
    lsm6dsm_rounding_t val) {
    lsm6dsm_ctrl5_c_t ctrl5_c;
    int32_t ret;

    ret = lsm6dsm_read_reg(ctx, LSM6DSM_CTRL5_C, (uint8_t*)&ctrl5_c, 1);

    if (ret == 0) {
        ctrl5_c.rounding = (uint8_t)val;
        ret = lsm6dsm_write_reg(ctx, LSM6DSM_CTRL5_C, (uint8_t*)&ctrl5_c, 1);
    }

    return ret;
}

/**
  * @brief  Circular burst-mode (rounding) read from output registers
  *         through the primary interface.[get]
  *
  * @param  ctx    Read / write interface definitions
  * @param  val    Get the values of rounding in reg CTRL5_C
  * @retval        Interface status (MANDATORY: return 0 -> no Error).
  *
  */
int32_t lsm6dsm_rounding_mode_get(const stmdev_ctx_t* ctx,
    lsm6dsm_rounding_t* val) {
    lsm6dsm_ctrl5_c_t ctrl5_c;
    int32_t ret;

    ret = lsm6dsm_read_reg(ctx, LSM6DSM_CTRL5_C, (uint8_t*)&ctrl5_c, 1);

    switch (ctrl5_c.rounding) {
        case LSM6DSM_ROUND_DISABLE:
            *val = LSM6DSM_ROUND_DISABLE;
            break;

        case LSM6DSM_ROUND_XL:
            *val = LSM6DSM_ROUND_XL;
            break;

        case LSM6DSM_ROUND_GY:
            *val = LSM6DSM_ROUND_GY;
            break;

        case LSM6DSM_ROUND_GY_XL:
            *val = LSM6DSM_ROUND_GY_XL;
            break;

        case LSM6DSM_ROUND_SH1_TO_SH6:
            *val = LSM6DSM_ROUND_SH1_TO_SH6;
            break;

        case LSM6DSM_ROUND_XL_SH1_TO_SH6:
            *val = LSM6DSM_ROUND_XL_SH1_TO_SH6;
            break;

        case LSM6DSM_ROUND_GY_XL_SH1_TO_SH12:
            *val = LSM6DSM_ROUND_GY_XL_SH1_TO_SH12;
            break;

        case LSM6DSM_ROUND_GY_XL_SH1_TO_SH6:
            *val = LSM6DSM_ROUND_GY_XL_SH1_TO_SH6;
            break;

        default:
            *val = LSM6DSM_ROUND_DISABLE;
            break;
    }

    return ret;
}

/**
  * @brief  Temperature data output register (r). L and H registers together
  *         express a 16-bit word in two’s complement.[get]
  *
  * @param  ctx    Read / write interface definitions
  * @param  buff   Buffer that stores data read
  * @retval        Interface status (MANDATORY: return 0 -> no Error).
  *
  */
int32_t lsm6dsm_temperature_raw_get(const stmdev_ctx_t* ctx, int16_t* val) {
    uint8_t buff[2];
    int32_t ret;

    ret = lsm6dsm_read_reg(ctx, LSM6DSM_OUT_TEMP_L, buff, 2);
    val[0] = (int16_t)buff[1];
    val[0] = (val[0] * 256) + (int16_t)buff[0];

    return ret;
}

/**
  * @brief  Angular rate sensor. The value is expressed as a 16-bit word in
  *         two’s complement.[get]
  *
  * @param  ctx    Read / write interface definitions
  * @param  buff   Buffer that stores data read
  * @retval        Interface status (MANDATORY: return 0 -> no Error).
  *
  */
int32_t lsm6dsm_angular_rate_raw_get(const stmdev_ctx_t* ctx, int16_t* val) {
    uint8_t buff[6];
    int32_t ret;

    ret = lsm6dsm_read_reg(ctx, LSM6DSM_OUTX_L_G, buff, 6);
    val[0] = (int16_t)buff[1];
    val[0] = (val[0] * 256) + (int16_t)buff[0];
    val[1] = (int16_t)buff[3];
    val[1] = (val[1] * 256) + (int16_t)buff[2];
    val[2] = (int16_t)buff[5];
    val[2] = (val[2] * 256) + (int16_t)buff[4];

    return ret;
}

/**
  * @brief  Linear acceleration output register. The value is expressed
  *         as a 16-bit word in two’s complement.[get]
  *
  * @param  ctx    Read / write interface definitions
  * @param  buff   Buffer that stores data read
  * @retval        Interface status (MANDATORY: return 0 -> no Error).
  *
  */
int32_t lsm6dsm_acceleration_raw_get(const stmdev_ctx_t* ctx, int16_t* val) {
    uint8_t buff[6];
    int32_t ret;

    ret = lsm6dsm_read_reg(ctx, LSM6DSM_OUTX_L_XL, buff, 6);
    val[0] = (int16_t)buff[1];
    val[0] = (val[0] * 256) + (int16_t)buff[0];
    val[1] = (int16_t)buff[3];
    val[1] = (val[1] * 256) + (int16_t)buff[2];
    val[2] = (int16_t)buff[5];
    val[2] = (val[2] * 256) + (int16_t)buff[4];

    return ret;
}

/**
  * @brief  External magnetometer raw data.[get]
  *
  * @param  ctx    Read / write interface definitions
  * @param  buff   Buffer that stores data read
  * @retval        Interface status (MANDATORY: return 0 -> no Error).
  *
  */
int32_t lsm6dsm_mag_calibrated_raw_get(const stmdev_ctx_t* ctx,
    int16_t* val) {
    uint8_t buff[6];
    int32_t ret;

    ret = lsm6dsm_read_reg(ctx, LSM6DSM_OUT_MAG_RAW_X_L, buff, 6);
    val[0] = (int16_t)buff[1];
    val[0] = (val[0] * 256) + (int16_t)buff[0];
    val[1] = (int16_t)buff[3];
    val[1] = (val[1] * 256) + (int16_t)buff[2];
    val[2] = (int16_t)buff[5];
    val[2] = (val[2] * 256) + (int16_t)buff[4];

    return ret;
}

/**
  * @brief  Read data in FIFO.[get]
  *
  * @param  ctx    Read / write interface definitions
  * @param  buffer Data buffer to store FIFO data.
  * @param  len    Number of data to read from FIFO.
  * @retval        Interface status (MANDATORY: return 0 -> no Error).
  *
  */
int32_t lsm6dsm_fifo_raw_data_get(const stmdev_ctx_t* ctx, uint8_t* buffer,
    uint8_t len) {
    int32_t ret;

    ret = lsm6dsm_read_reg(ctx, LSM6DSM_FIFO_DATA_OUT_L, buffer, len);

    return ret;
}

/**
  * @}
  *
  */

  /**
    * @defgroup    LSM6DSM_common
    * @brief       This section groups common useful functions.
    * @{
    *
    */

    /**
      * @brief  Enable access to the embedded functions/sensor hub
      *         configuration registers[set]
      *
      * @param  ctx    Read / write interface definitions
      * @param  val    Change the values of func_cfg_en in reg FUNC_CFG_ACCESS
      * @retval        Interface status (MANDATORY: return 0 -> no Error).
      *
      */
int32_t lsm6dsm_mem_bank_set(const stmdev_ctx_t* ctx,
    lsm6dsm_func_cfg_en_t val) {
    lsm6dsm_func_cfg_access_t func_cfg_access;
    int32_t ret;

    ret = lsm6dsm_read_reg(ctx, LSM6DSM_FUNC_CFG_ACCESS,
        (uint8_t*)&func_cfg_access, 1);

    if (ret == 0) {
        func_cfg_access.func_cfg_en = (uint8_t)val;
        ret = lsm6dsm_write_reg(ctx, LSM6DSM_FUNC_CFG_ACCESS,
            (uint8_t*)&func_cfg_access, 1);
    }

    return ret;
}
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
