NifleySnifley/RocketTracker/(commit log)

2022-06-30 Configuration file, indev auto-calibration
2022-07-01 Working calibration, indev IMU
2022-07-01 Improved IMU reading
2022-07-20 Switched to PlatformIO and added protobufs
2022-07-27 Custom driver working for transmitting
2022-07-29 Fully operational driver
2022-08-05 Basic amenities for event relaying
2023-04-13 Woah there! Started everything over. Added PCBs.
    [BaseStationHAT-B_Cu.gbr, BaseStationHAT-B_Mask.gbr, BaseStationHAT-B_Silkscreen.gbr, BaseStationHAT-Edge_Cuts.gbr, BaseStationHAT-F_Cu.gbr, BaseStationHAT-F_Mask.gbr, BaseStationHAT-F_Paste.gbr, BaseStationHAT-F_Silkscreen.gbr]
2023-04-13 I'm dumb, made PCBs submod and added SW dir
    [BaseStationHAT-B_Cu.gbr, BaseStationHAT-B_Mask.gbr, BaseStationHAT-B_Silkscreen.gbr, BaseStationHAT-Edge_Cuts.gbr, BaseStationHAT-F_Cu.gbr, BaseStationHAT-F_Mask.gbr, BaseStationHAT-F_Paste.gbr, BaseStationHAT-F_Silkscreen.gbr]
2023-08-18 Protocol things, DMA based asyncrhonous radio driver upgrades.
2023-08-19 Basic TinyUSB CDC ports, reset, etc.
    [main.cpp, tusb_config.h]
2023-08-20 Emulated NMEA GPS for received messages, fixed driver
    [main.cpp, pinout.h, radio.cpp, radio.h, tusb_config.h, vgps.cpp, vgps.h]
2023-08-28 Fixes for configuration of receiver w/ NMEA. No more CR config
    [de_esc.py, main.cpp, radio.cpp]
2023-09-06 CRC check in framemanager for extra safety
2023-09-07 Overall, software works! Could use some improvements to be viable for 100% duty cycle (serial thread, etc.) but oherwise it's OK
2024-07-04 3 Sensors Working for firmware v3
2024-07-06 Minor frame_manager fix (struct packing)
    [main.c]
2024-07-06 Fixes to software & frame manager, needs merge
    [main.cpp, testsend.py, util.py, vgps.cpp]
2024-07-07 Receiver fixes for new protocols
    [main.cpp]
2024-07-09 CLI, prototype log downloading (NEEDS TESTING)
2024-07-10 ADXL375 driver
2024-07-12 Critical fix: GPS lon overriden by altitude!
    [main.c, tracker_config.h]
2024-07-25 Configuration, calibration in firmware
    [configuration.h]
2024-07-29 Filter commit
2024-07-29 Tuned filter
2024-08-04 Log manipulation, fixes, etc.
    [cli.py, loglib.py, sensors.c, util.py]
2024-08-06 Link LoRa improvements, rebooting, etc.
    [cli.py, link.py, loglib.py, logtool.py, mag_cal.py, main.c]
2024-08-07 Misc features, mostly CLI oriented
    [configuration.h]
2024-08-08 Sensor disabling, and "recovery" from sensor init failure.
    [main.c, sensors.c, sensors.h]
2024-08-09 TCP WIP Commit
    [partitions.csv]
